buckket/sclock/hardware/sclock_new/sclock_new.kicad_pcb

## KiCad design hardware/sclock_new/sclock_new.kicad_pcb (2022-11-19)

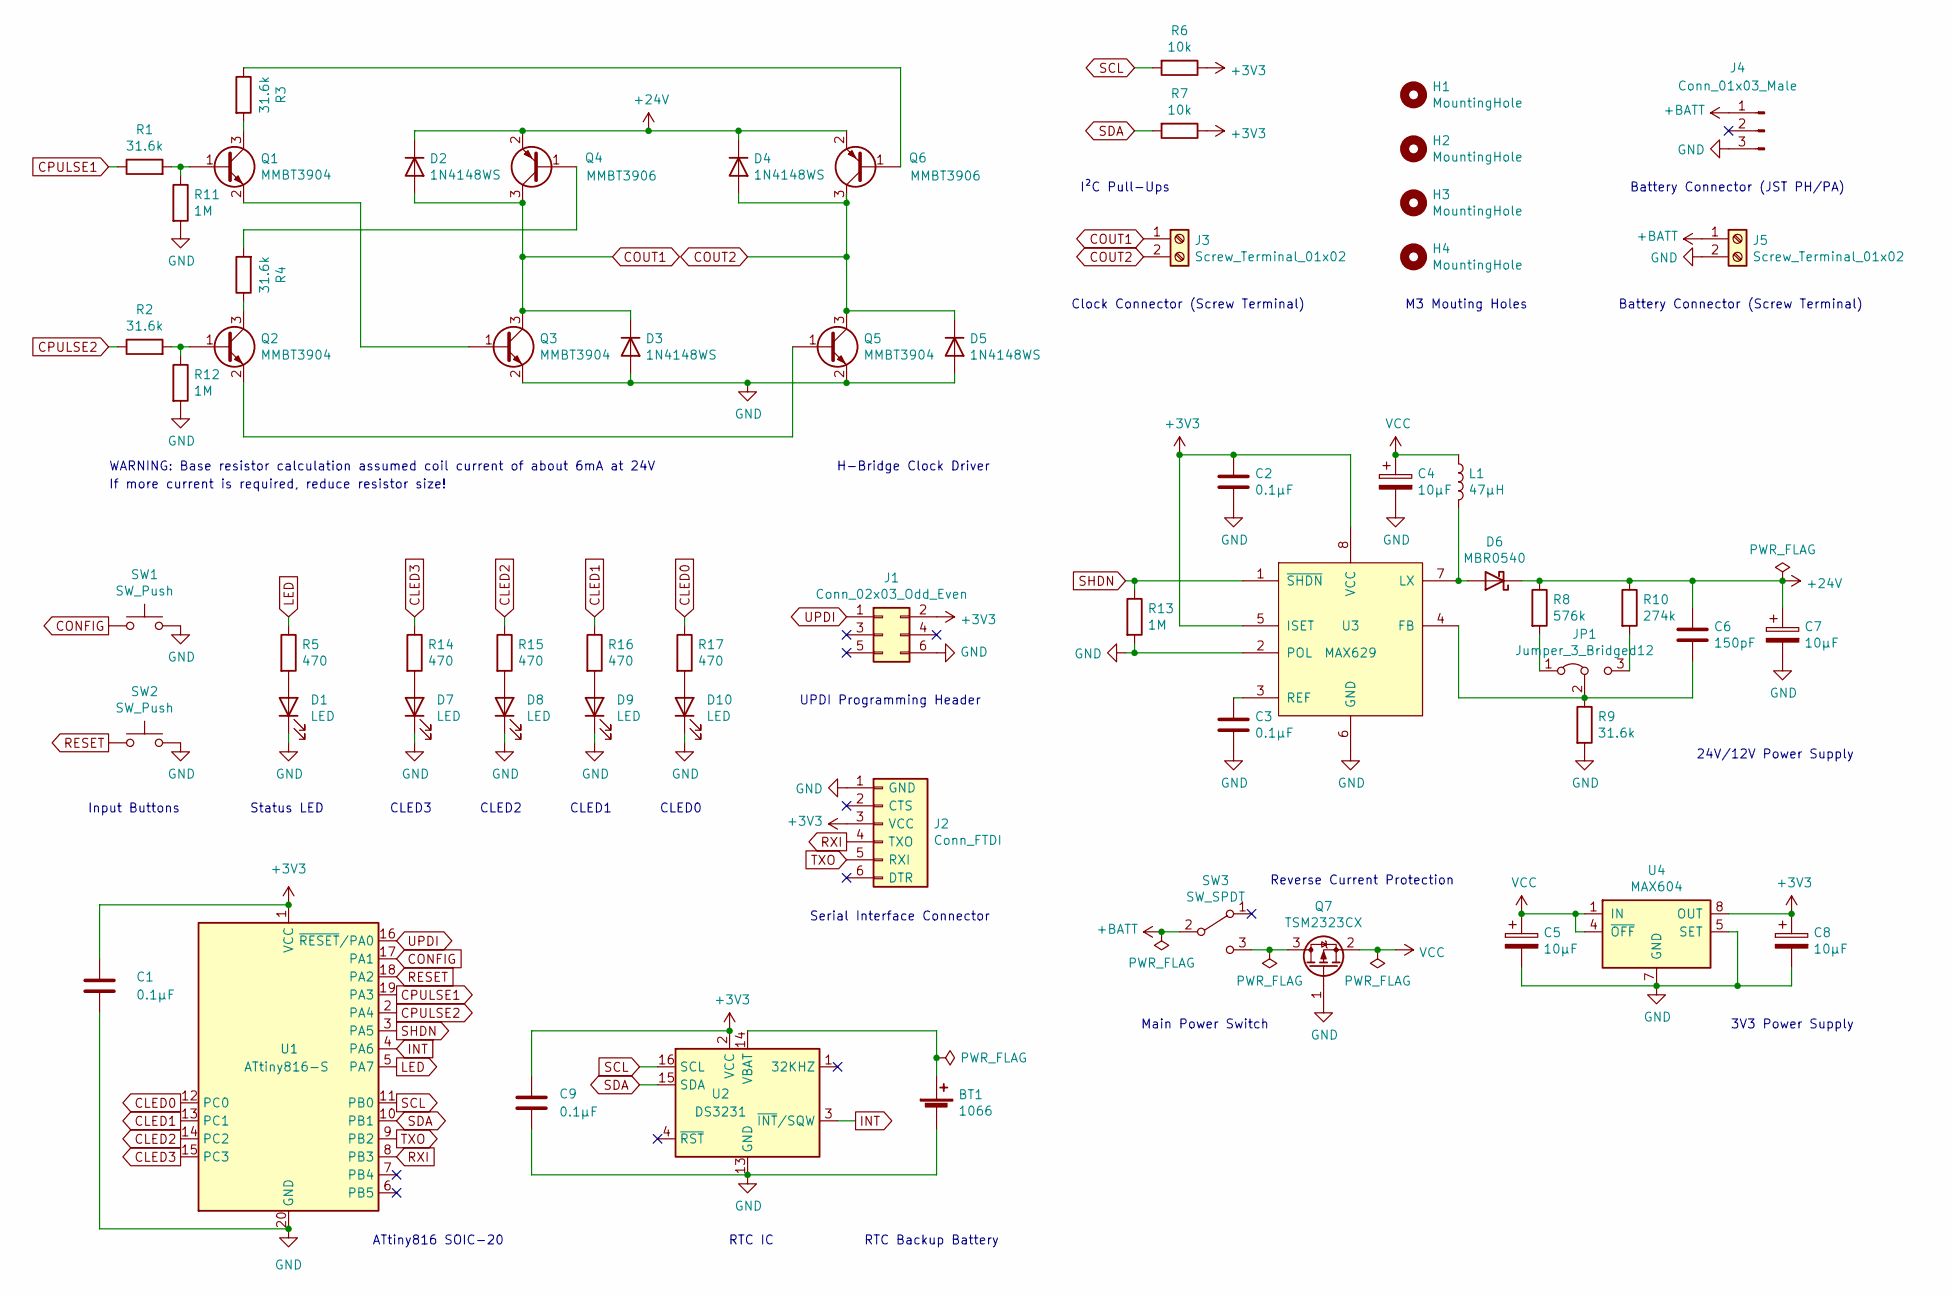
[picture p1: schematic sclock_new.kicad_sch, slock]

Parts:
BT1: 1066; BatteryHolder_Keystone_1066_1x2032; MPN 1066
C1, C2, C3, C9: 0.1µF; C_0805_2012Metric_Pad1.18x1.45mm_HandSolder; MPN C0805C104K5RACTU
C4, C7: 10µF; CP_EIA-7343-31_Kemet-D_Pad2.25x2.55mm_HandSolder; MPN T495D106K035ATE125
C5, C8: 10µF; CP_EIA-3216-18_Kemet-A_Pad1.58x1.35mm_HandSolder; MPN T494A106K010AT
C6: 150pF; C_0805_2012Metric_Pad1.18x1.45mm_HandSolder; MPN C0805C151J5GACTU
D1: LED; LED_0805_2012Metric_Pad1.15x1.40mm_HandSolder; MPN 150080VS75000
D2, D3, D4, D5: 1N4148WS; D_SOD-323_HandSoldering; MPN 1N4148WS
D6: MBR0540; D_SOD-123; MPN MBR0540T3G
D7, D8, D9, D10: LED; LED_0805_2012Metric_Pad1.15x1.40mm_HandSolder; MPN 150080YS75000
H1, H2, H3, H4: MountingHole; MountingHole_3.2mm_M3_Pad
J1: Conn_02x03_Odd_Even; PinHeader_2x03_P2.54mm_Vertical
J2: Conn_FTDI; PinHeader_1x06_P2.54mm_Horizontal
J3, J5: Screw_Terminal_01x02; TerminalBlock_4Ucon_1x02_P3.50mm_Horizontal; MPN 0393570002
J4: Conn_01x03_Male; JST_PH_B3B-PH-K_1x03_P2.00mm_Vertical
JP1: Jumper_3_Bridged12; PinHeader_1x03_P2.54mm_Vertical
L1: 47µH; L_Wuerth_WE-PD-Typ-LS_Handsoldering; MPN DR125-470-R
Q1, Q2, Q3, Q5: MMBT3904; SOT-23_Handsoldering; MPN MMBT3904LT1G
Q4, Q6: MMBT3906; SOT-23_Handsoldering; MPN MMBT3906LT1G
Q7: TSM2323CX; SOT-23_Handsoldering; MPN TSM2323CX RFG
R1, R2, R3, R4, R9: 31.6k; R_0805_2012Metric_Pad1.20x1.40mm_HandSolder; MPN RC0805FR-0731K6L
R5, R14, R15, R16, R17: 470; R_0805_2012Metric_Pad1.20x1.40mm_HandSolder; MPN RC0805FR-07470RL
R6, R7: 10k; R_0805_2012Metric_Pad1.20x1.40mm_HandSolder; MPN RC0805FR-0710KL
R8: 576k; R_0805_2012Metric_Pad1.20x1.40mm_HandSolder; MPN RC0805FR-07576KL
R10: 274k; R_0805_2012Metric_Pad1.20x1.40mm_HandSolder; MPN RC0805FR-07274KL
R11, R12, R13: 1M; R_0805_2012Metric_Pad1.20x1.40mm_HandSolder; MPN RC0805FR-071ML
SW1, SW2: SW_Push; SW_SPST_TL3342; MPN TL3342F160QG/TR
SW3: SW_SPDT; SW_E-Switch_EG1271_DPDT; MPN EG1271
U1: ATtiny816-S; SOIC-20W_7.5x12.8mm_P1.27mm; MPN ATTINY816-SFR
U2: DS3231; SOIC-16W_7.5x10.3mm_P1.27mm; MPN DS3231S#T&R
U3: MAX629; SOIC-8_3.9x4.9mm_P1.27mm; MPN MAX629ESA+
U4: MAX604; SOIC-8_3.9x4.9mm_P1.27mm; MPN MAX604ESA+

Connections:
+3V3: C1.1, C2.1, C8.1, C9.1, J1.2, J2.3 (VCC), R6.1, R7.1, U1.1 (VCC), U2.2 (VCC), U3.5 (ISET), U3.8 (VCC), U4.8 (OUT)
+24V: C6.1, C7.1, D2.1 (K), D4.1 (K), D6.1 (K), Q4.2 (E), Q6.2 (E), R8.1, R10.1
+BATT: J4.1, J5.1, SW3.2 (B)
CLED0: R17.1, U1.12 (PC0)
CLED1: R16.1, U1.13 (PC1)
CLED2: R15.1, U1.14 (PC2)
CLED3: R14.1, U1.15 (PC3)
CONFIG: SW1.1, U1.17 (PA1)
COUT1: D2.2 (A), D3.1 (K), J3.1, Q3.3 (C), Q4.3 (C)
COUT2: D4.2 (A), D5.1 (K), J3.2, Q5.3 (C), Q6.3 (C)
CPULSE1: R1.1, U1.19 (PA3)
CPULSE2: R2.1, U1.2 (PA4)
GND: BT1.2 (-), C1.2, C2.2, C3.2, C4.2, C5.2, C7.2, C8.2, C9.2, D1.1 (K), D3.2 (A), D5.2 (A), D7.1 (K), D8.1 (K), D9.1 (K), D10.1 (K), J1.6, J2.1 (GND), J4.3, J5.2, Q3.2 (E), Q5.2 (E), Q7.1 (G), R9.2, R11.2, R12.2, R13.2, SW1.2, SW2.2, U1.20 (GND), U2.5 (GND), U2.6 (GND), U2.7 (GND), U2.8 (GND), U2.9 (GND), U2.10 (GND), U2.11 (GND), U2.12 (GND), U2.13 (GND), U3.2 (POL), U3.6 (GND), U4.2 (GND), U4.3 (GND), U4.5 (SET), U4.6 (GND), U4.7 (GND)
INT: U1.4 (PA6), U2.3 (~INT/SQW)
LED: R5.1, U1.5 (PA7)
unnamed: BT1.1 (+), U2.14 (VBAT)
unnamed: C3.1, U3.3 (REF)
unnamed: C6.2, JP1.2 (C), R9.1, U3.4 (FB)
unnamed: D1.2 (A), R5.2
unnamed: D6.2 (A), L1.2, U3.7 (LX)
unnamed: D7.2 (A), R14.2
unnamed: D8.2 (A), R15.2
unnamed: D9.2 (A), R16.2
unnamed: D10.2 (A), R17.2
unnamed: JP1.1 (A), R8.2
unnamed: JP1.3 (B), R10.2
unnamed: Q1.1 (B), R1.2, R11.1
unnamed: Q1.2 (E), Q3.1 (B)
unnamed: Q1.3 (C), R3.2
unnamed: Q2.1 (B), R2.2, R12.1
unnamed: Q2.2 (E), Q5.1 (B)
unnamed: Q2.3 (C), R4.1
unnamed: Q4.1 (B), R4.2
unnamed: Q6.1 (B), R3.1
unnamed: Q7.3 (D), SW3.3 (C)
RESET: SW2.1, U1.18 (PA2)
RXI: J2.4 (TXO), U1.8 (PB3)
SCL: R6.2, U1.11 (PB0), U2.16 (SCL)
SDA: R7.2, U1.10 (PB1), U2.15 (SDA)
SHDN: R13.1, U1.3 (PA5), U3.1 (~SHDN)
TXO: J2.5 (RXI), U1.9 (PB2)
UPDI: J1.1, U1.16 (~RESET/PA0)
VCC: C4.1, C5.1, L1.1, Q7.2 (S), U4.1 (IN), U4.4 (~OFF)

Notes on the sheet:
M3 Mouting Holes
RTC Backup Battery
ATtiny816 SOIC-20
Battery Connector (JST PH/PA)
Reverse Current Protection
RTC IC
UPDI Programming Header
CLED2
CLED3
Main Power Switch
WARNING: Base resistor calculation assumed coil current of about 6mA at 24V
Clock Connector (Screw Terminal)
Battery Connector (Screw Terminal)
3V3 Power Supply
Status LED
24V/12V Power Supply
CLED0
H-Bridge Clock Driver
I²C Pull-Ups
Serial Interface Connector
If more current is required, reduce resistor size!
Input Buttons
CLED1

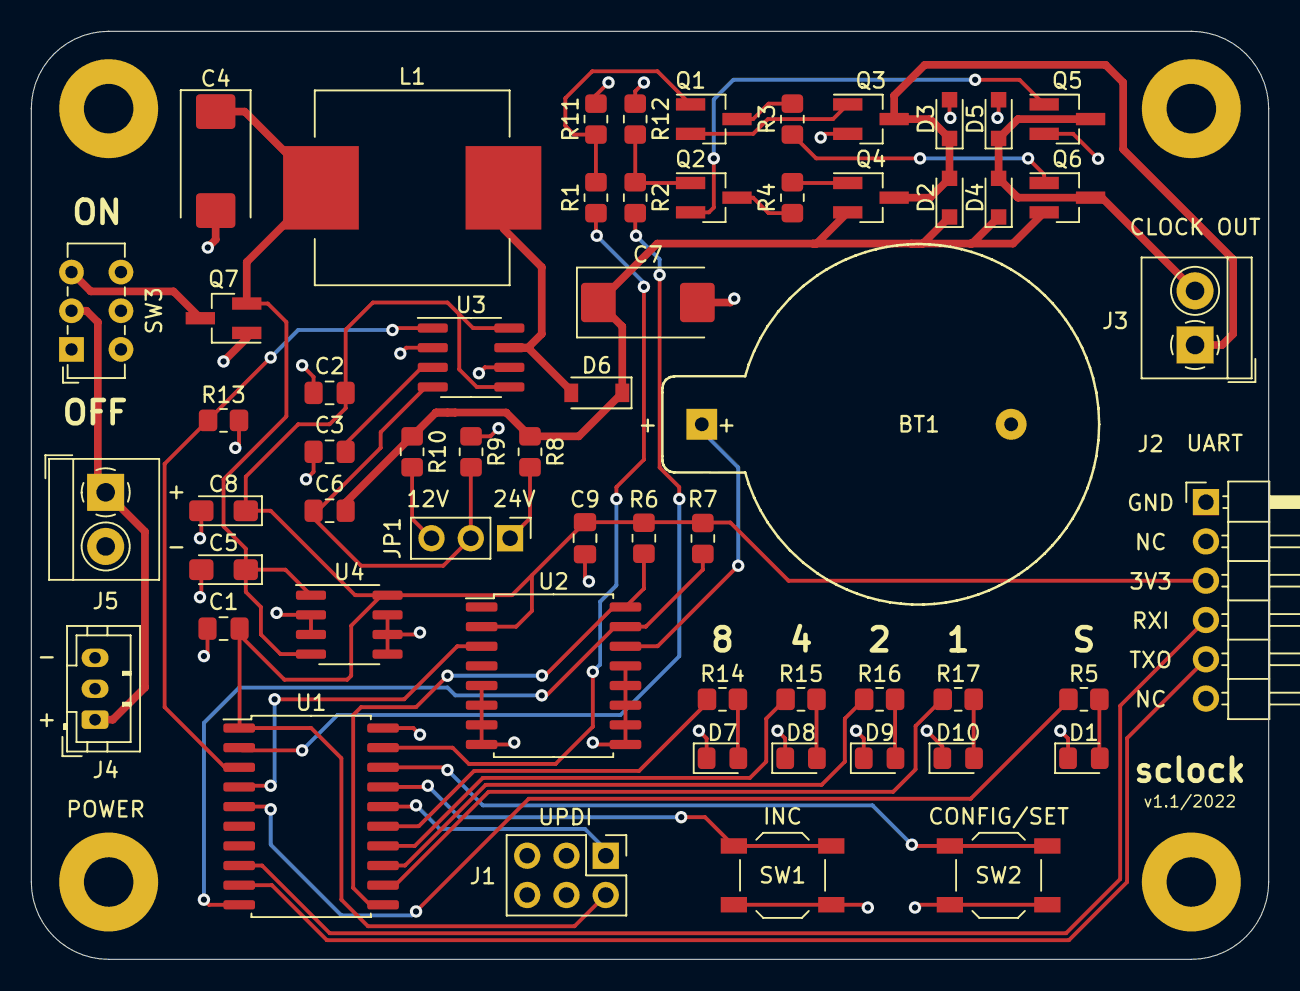
[picture p2: board sclock_new.kicad_pcb from above]

Board: 2 copper layers, 80.0 x 60.0 mm, 62 parts (0 on the bottom side), 43 nets.
