buckket/sclock/hardware/adapter.kicad_pcb

## KiCad design hardware/adapter.kicad_pcb (2021-03-06)

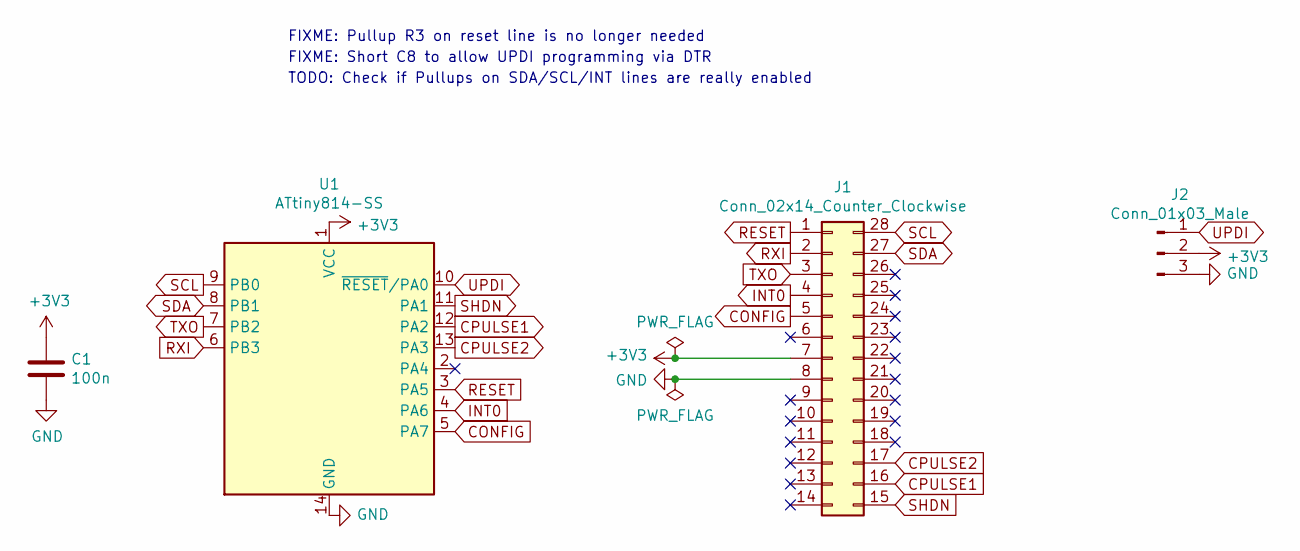
[picture p3: schematic adapter.sch]

Parts:
C1: 100n; C_0805_2012Metric_Pad1.18x1.45mm_HandSolder
J1: Conn_02x14_Counter_Clockwise; DIP-28_W7.62mm
J2: Conn_01x03_Male; PinSocket_1x03_P2.54mm_Vertical
U1: ATtiny814-SS; SOIC-14_3.9x8.7mm_P1.27mm

Connections:
+3V3: C1.1, J1.7, J2.2, U1.1 (VCC)
CONFIG: J1.5, U1.5 (PA7)
CPULSE1: J1.16, U1.12 (PA2)
CPULSE2: J1.17, U1.13 (PA3)
GND: C1.2, J1.8, J2.3, U1.14 (GND)
INT0: J1.4, U1.4 (PA6)
RESET: J1.1, U1.3 (PA5)
RXI: J1.2, U1.6 (PB3)
SCL: J1.28, U1.9 (PB0)
SDA: J1.27, U1.8 (PB1)
SHDN: J1.15, U1.11 (PA1)
TXO: J1.3, U1.7 (PB2)
UPDI: J2.1, U1.10 (~RESET~/PA0)

Notes on the sheet:
FIXME: Pullup R3 on reset line is no longer needed
FIXME: Short C8 to allow UPDI programming via DTR
TODO: Check if Pullups on SDA/SCL/INT lines are really enabled

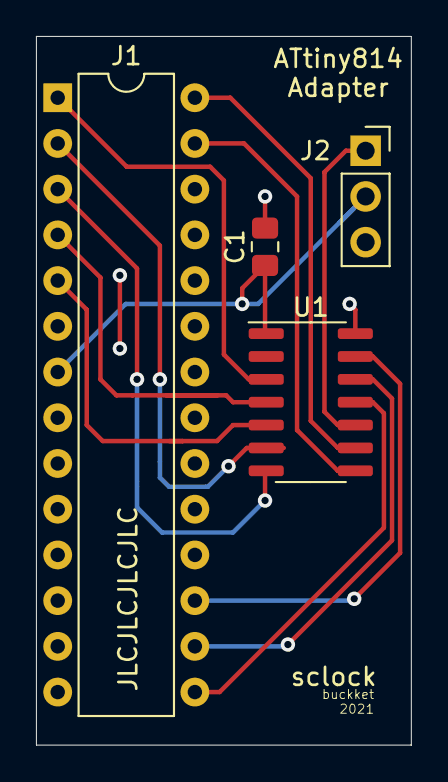
[picture p4: board adapter.kicad_pcb from above]

Board: 2 copper layers, 20.8 x 39.4 mm, 4 parts (0 on the bottom side), 13 nets.
