buckket/sclock/hardware/sclock.kicad_pcb

## KiCad design hardware/sclock.kicad_pcb (2021-03-06)

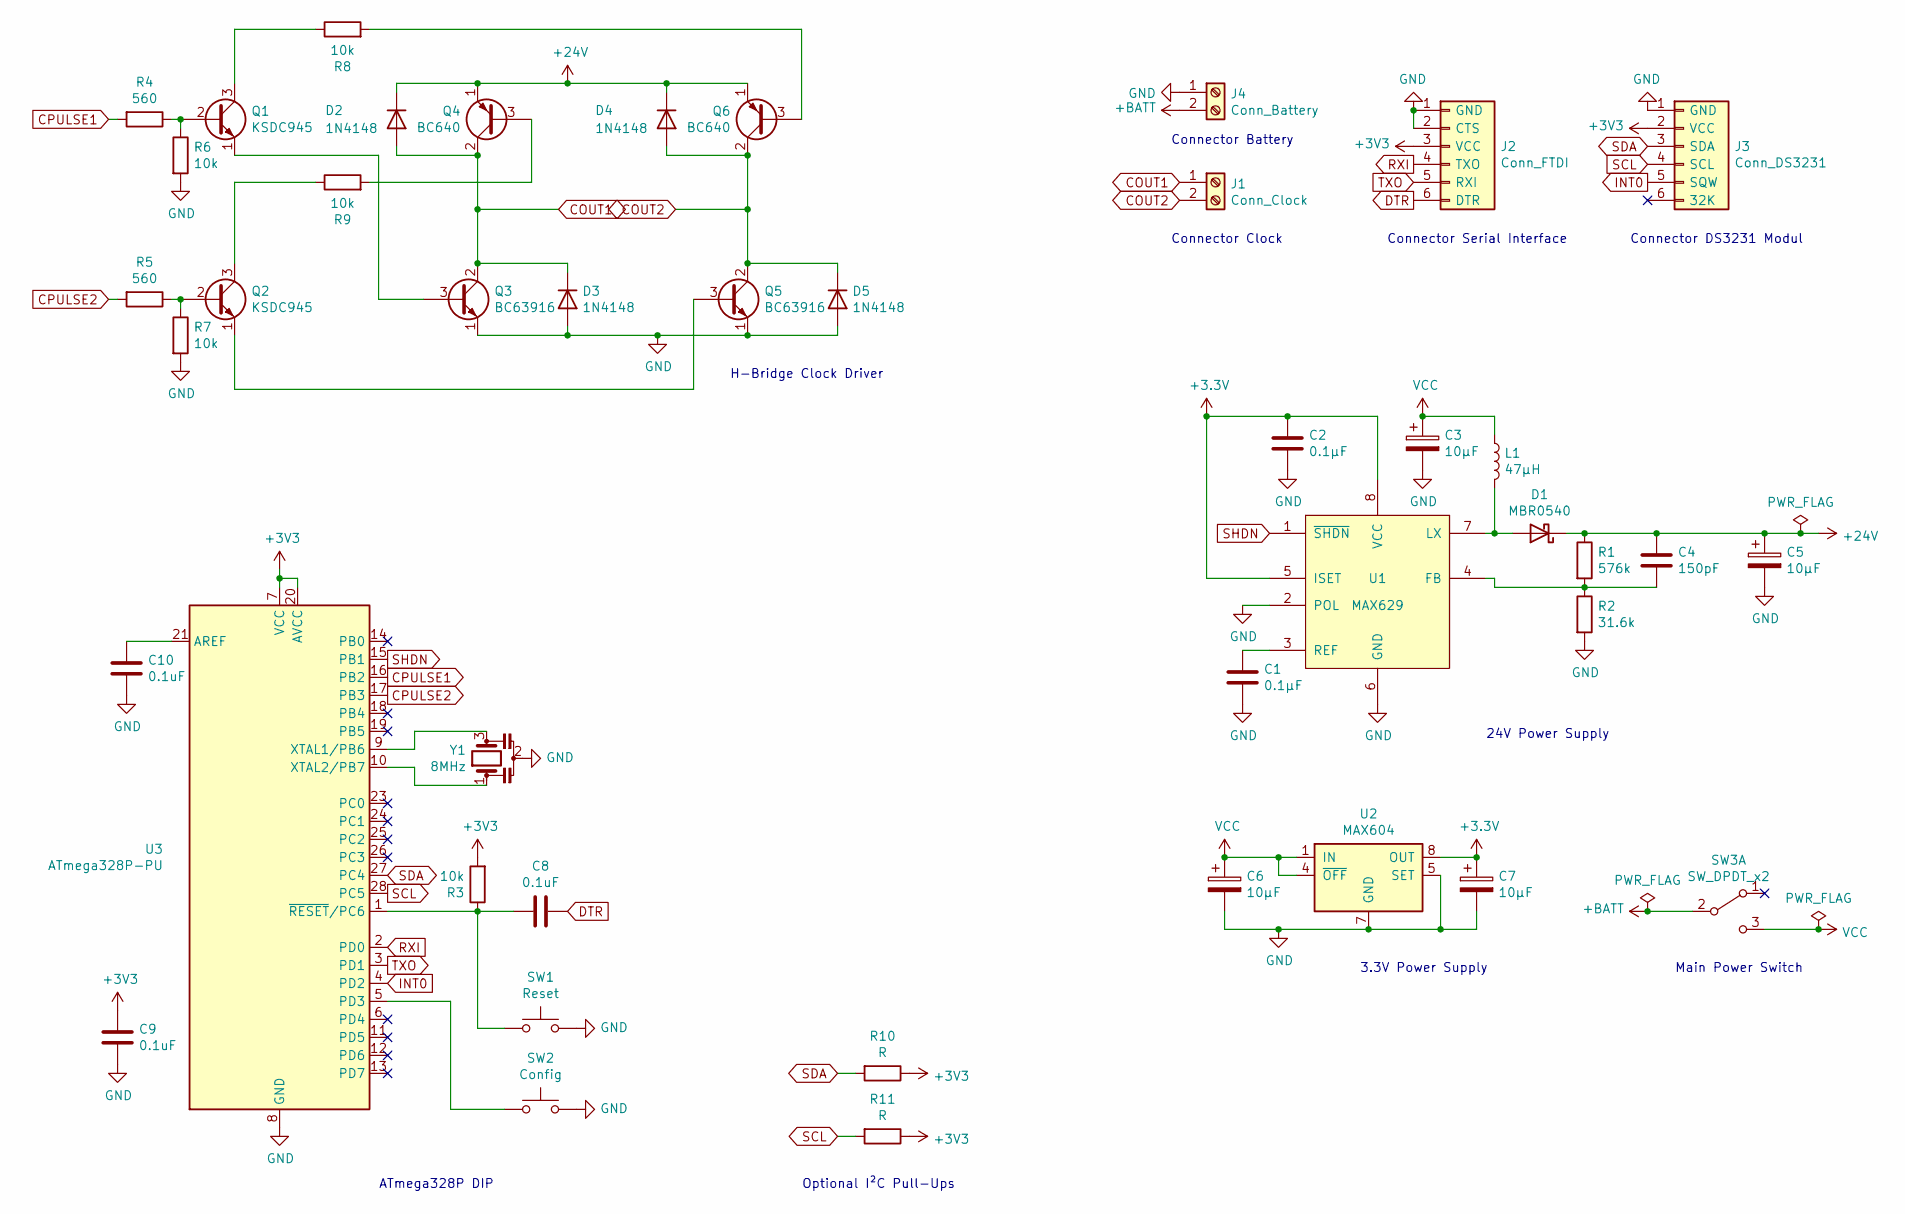
[picture p5: schematic sclock.sch]

Parts:
C1, C2: 0.1µF; C_0805_2012Metric_Pad1.15x1.40mm_HandSolder
C3, C5, C6, C7: 10µF; CP_Radial_D5.0mm_P2.00mm
C4: 150pF; C_0805_2012Metric_Pad1.15x1.40mm_HandSolder
C8, C9, C10: 0.1uF; C_0805_2012Metric_Pad1.15x1.40mm_HandSolder
D1: MBR0540; D_SOD-123
D2, D3, D4, D5: 1N4148; D_DO-35_SOD27_P7.62mm_Horizontal
J1: Conn_Clock; TerminalBlock_4Ucon_1x02_P3.50mm_Horizontal
J2: Conn_FTDI; PinHeader_1x06_P2.54mm_Vertical
J3: Conn_DS3231; PinHeader_1x06_P2.54mm_Horizontal
J4: Conn_Battery; TerminalBlock_4Ucon_1x02_P3.50mm_Horizontal
L1: 47µH; L_Wuerth_WE-PD-Typ-LS_Handsoldering
Q1, Q2: KSDC945; TO-92
Q3, Q5: BC63916; TO-92
Q4, Q6: BC640; TO-92
R1: 576k; R_0805_2012Metric_Pad1.15x1.40mm_HandSolder
R2: 31.6k; R_0805_2012Metric_Pad1.15x1.40mm_HandSolder
R3, R6, R7, R8, R9: 10k; R_0805_2012Metric_Pad1.15x1.40mm_HandSolder
R4, R5: 560; R_0805_2012Metric_Pad1.15x1.40mm_HandSolder
R10, R11: R; R_0805_2012Metric_Pad1.15x1.40mm_HandSolder
SW1: Reset; SW_PUSH_6mm
SW2: Config; SW_PUSH_6mm
SW3: SW_DPDT_x2; Slide_Switch_DPDT
U1: MAX629; SOIC-8_3.9x4.9mm_P1.27mm
U2: MAX604; SOIC-8_3.9x4.9mm_P1.27mm
U3: ATmega328P-PU; DIP-28_W7.62mm
Y1: 8MHz; Resonator_SMD_muRata_SFECV-3Pin_6.9x2.9mm_HandSoldering

Connections:
+24V: C4.1, C5.1, D1.1 (K), D2.1 (K), D4.1 (K), Q4.1 (E), Q6.1 (E), R1.1
+BATT: J4.2, SW3.2 (B); also elsewhere on the board
COUT1: D2.2 (A), D3.1 (K), J1.1, Q3.2 (C), Q4.2 (C); also elsewhere on the board
COUT2: D4.2 (A), D5.1 (K), J1.2, Q5.2 (C), Q6.2 (C); also elsewhere on the board
CPULSE1: R4.2, U3.16 (PB2)
CPULSE2: R5.2, U3.17 (PB3)
DTR: C8.2, J2.6 (DTR); also elsewhere on the board
GND: C1.2, C2.2, C3.2, C5.2, C6.2, C7.2, C9.2, C10.2, D3.2 (A), D5.2 (A), J2.1 (GND), J2.2 (CTS), J3.1 (GND), J4.1, Q3.1 (E), Q5.1 (E), R2.2, R6.2, R7.2, SW1.2, SW2.2, U1.2 (POL), U1.6 (GND), U2.2 (GND), U2.3 (GND), U2.5 (SET), U2.6 (GND), U2.7 (GND), U3.8 (GND), U3.22 (GND), Y1.2; also elsewhere on the board
INT0: J3.5 (SQW), U3.4 (PD2); also elsewhere on the board
unnamed: C1.1, U1.3 (REF)
unnamed: C4.2, R1.2, R2.1, U1.4 (FB)
unnamed: C8.1, R3.1, SW1.1, U3.1 (~RESET~/PC6)
unnamed: C10.1, U3.21 (AREF)
unnamed: D1.2 (A), L1.2, U1.7 (LX)
unnamed: Q1.1 (E), Q3.3 (B)
unnamed: Q1.2 (B), R4.1, R6.1
unnamed: Q1.3 (C), R8.1
unnamed: Q2.1 (E), Q5.3 (B)
unnamed: Q2.2 (B), R5.1, R7.1
unnamed: Q2.3 (C), R9.1
unnamed: Q4.3 (B), R9.2
unnamed: Q6.3 (B), R8.2
unnamed: SW2.1, U3.5 (PD3)
unnamed: U3.9 (XTAL1/PB6), Y1.3
unnamed: U3.10 (XTAL2/PB7), Y1.1
RXI: J2.4 (TXO), U3.2 (PD0); also elsewhere on the board
SCL: J3.4 (SCL), R11.2, U3.28 (PC5); also elsewhere on the board
SDA: J3.3 (SDA), R10.2, U3.27 (PC4); also elsewhere on the board
SHDN: U1.1 (~SHDN), U3.15 (PB1)
TXO: J2.5 (RXI), U3.3 (PD1); also elsewhere on the board
VCC: C3.1, C6.1, L1.1, SW3.3 (C), U2.1 (IN), U2.4 (~OFF)

Notes on the sheet:
24V Power Supply
Optional I²C Pull-Ups
ATmega328P DIP
Main Power Switch
3.3V Power Supply
H-Bridge Clock Driver
Connector DS3231 Modul
Connector Serial Interface
Connector Clock
Connector Battery

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
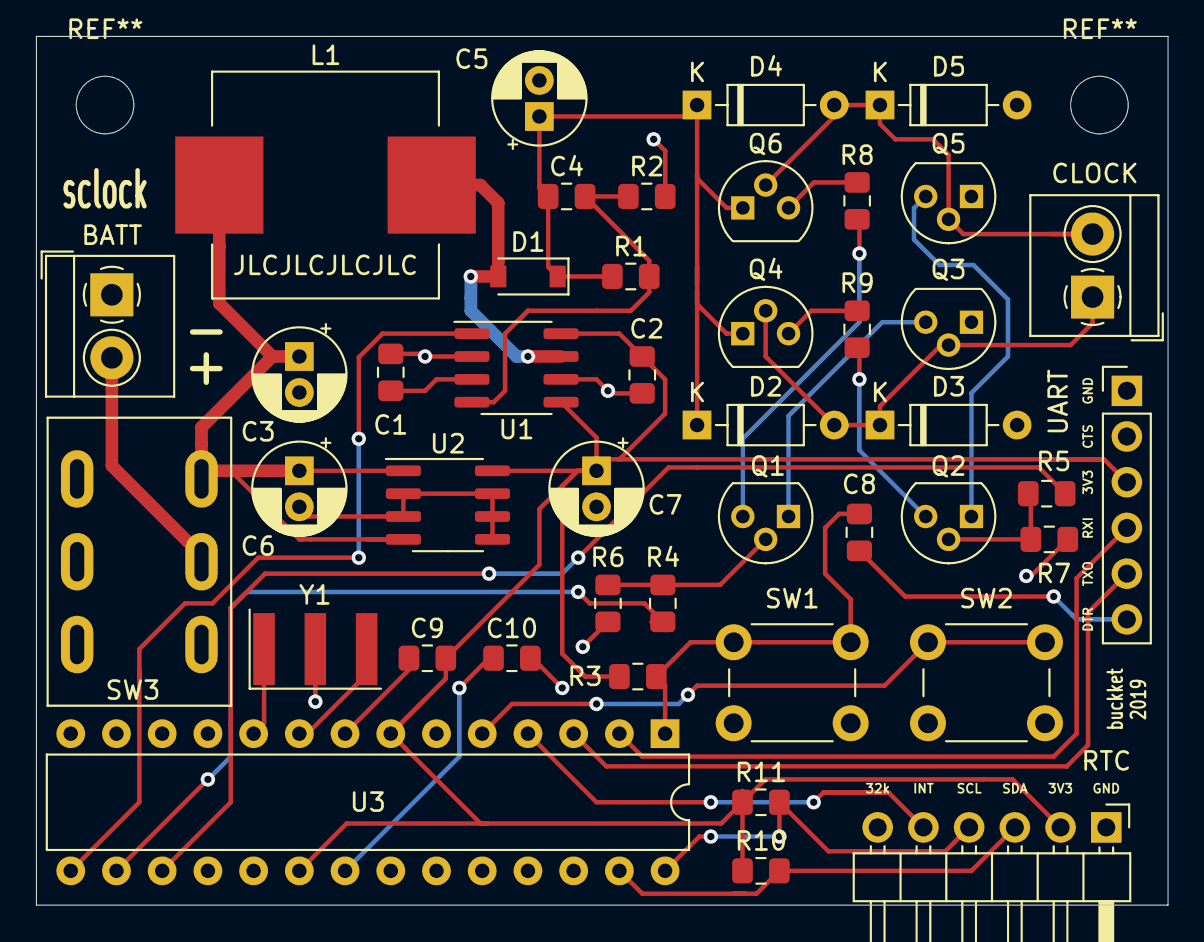
[picture p6: board sclock.kicad_pcb from above]

Board: 2 copper layers, 62.9 x 48.3 mm, 44 parts (0 on the bottom side), 32 nets.

Other parts of the board:
BATT: Conn_Battery; TerminalBlock_4Ucon_1x02_P3.50mm_Horizontal
CLOCK: Conn_Clock; TerminalBlock_4Ucon_1x02_P3.50mm_Horizontal
RTC: Conn_DS3231; PinHeader_1x06_P2.54mm_Horizontal
UART: Conn_FTDI; PinHeader_1x06_P2.54mm_Vertical

Their connections:
+BATT: BATT.2; also elsewhere on the board
COUT1: CLOCK.1; also elsewhere on the board
COUT2: CLOCK.2; also elsewhere on the board
DTR: UART.6; also elsewhere on the board
GND: BATT.1, RTC.1, UART.1, UART.2; also elsewhere on the board
INT0: RTC.5; also elsewhere on the board
RXI: UART.4; also elsewhere on the board
SCL: RTC.4; also elsewhere on the board
SDA: RTC.3; also elsewhere on the board
TXO: UART.5; also elsewhere on the board
