buckket/sclock/hardware/24v_power.kicad_pcb

## KiCad design hardware/24v_power.kicad_pcb (2019-09-01)

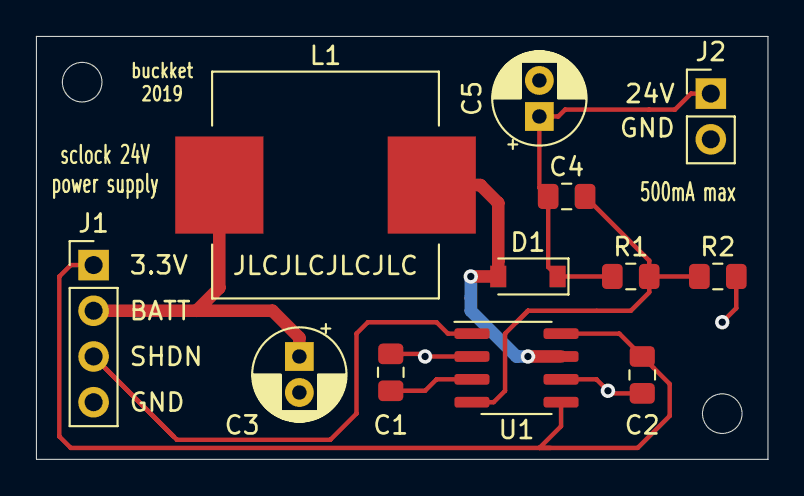
[picture p7: board 24v_power.kicad_pcb from above]

Board: 2 copper layers, 40.6 x 23.5 mm, 12 parts (0 on the bottom side), 8 nets.

Parts:
C1, C2: 0.1µF; C_0805_2012Metric_Pad1.15x1.40mm_HandSolder
C3, C5: 10µF; CP_Radial_D5.0mm_P2.00mm
C4: 150pF; C_0805_2012Metric_Pad1.15x1.40mm_HandSolder
D1: MBR0540; D_SOD-123
J1: Conn_01x04; PinHeader_1x04_P2.54mm_Vertical
J2: Conn_01x02; PinHeader_1x02_P2.54mm_Vertical
L1: 47µH; L_Wuerth_WE-PD-Typ-LS_Handsoldering
R1: 576k; R_0805_2012Metric_Pad1.15x1.40mm_HandSolder
R2: 31.6k; R_0805_2012Metric_Pad1.15x1.40mm_HandSolder
U1: MAX629; SOIC-8_3.9x4.9mm_P1.27mm

Connections:
+3V3: C2.1, J1.1, U1.5, U1.8
+24V: C4.1, C5.1, D1.1, J2.1, R1.1
+BATT: C3.1, J1.2, L1.1
GND: C1.2, C2.2, C3.2, C5.2, J1.4, J2.2, R2.2, U1.2, U1.6
unnamed: C1.1, U1.3
unnamed: C4.2, R1.2, R2.1, U1.4
unnamed: D1.2, L1.2, U1.7
SHDN: J1.3, U1.1
