buckket/sclock/(commit log)

2021-03-06 PCB for ATmega328
    [24v_power.kicad_pcb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]
2021-03-06 Add adapter PCB, reorganize files
    [adapter.kicad_pcb, adapter.sch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]
2021-03-26 Add Keystone 1066 battery holder footprint and 3D model
2021-03-26 New PCB dev state
    [sclock_new.kicad_pcb, sclock_new.sch]
2021-03-30 Fix inline function problem in clock.h
    [clock.h]
2021-11-05 New PCB changes
    [adapter.sch, sclock_new.csv, sclock_new.kicad_pcb, sclock_new.sch]
2022-11-19 PCB v1.1
    [sclock_new.kicad_pcb, sclock_new.kicad_sch]
